intelliputer/video-composites/atari/doc/pcb-snapshot.png

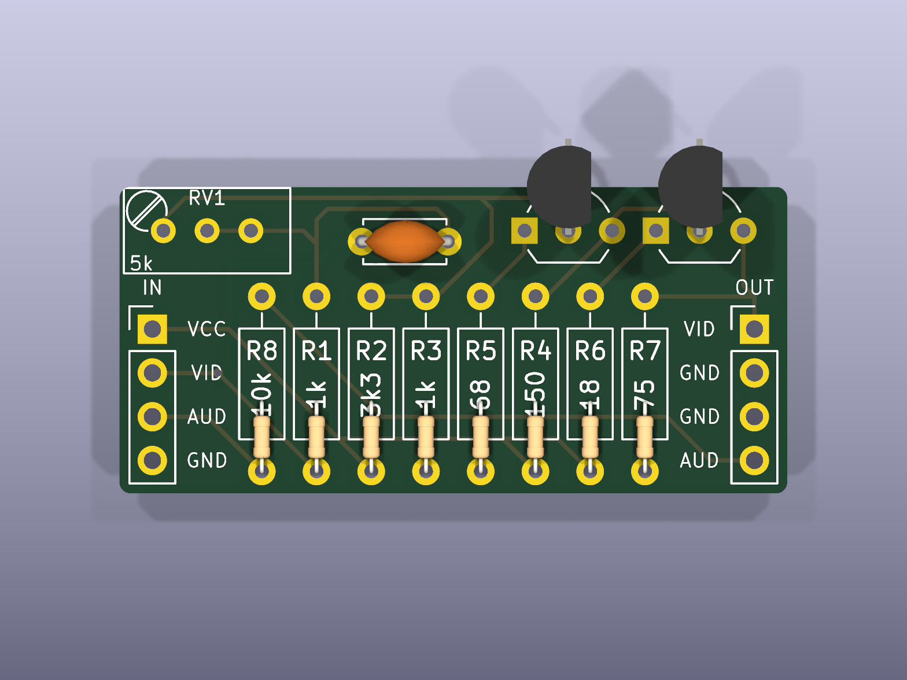
atari/doc/pcb-snapshot.png
