intelliputer/video-composites/atari/gallery/2019-01-28 23.04.03.jpg

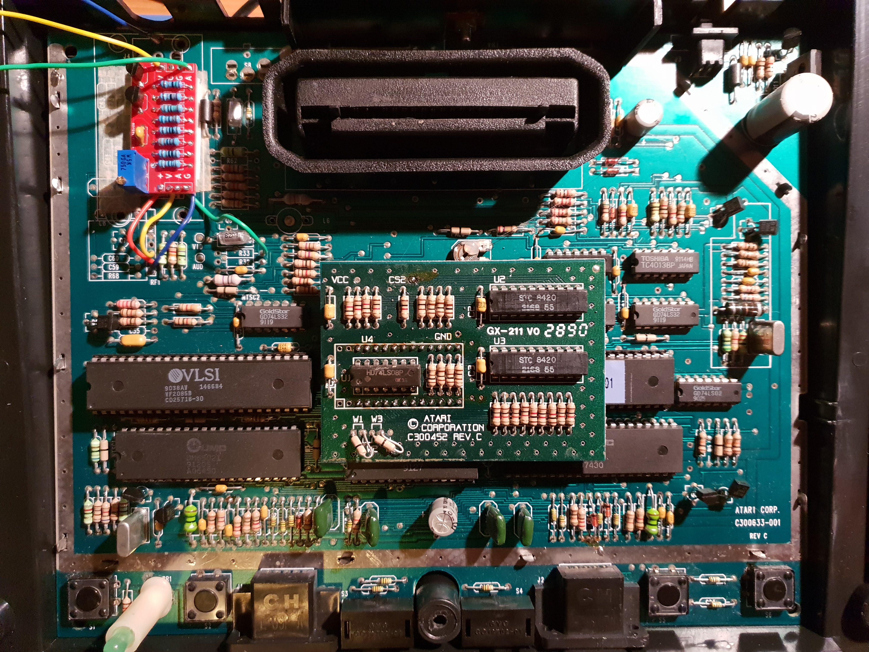
atari/gallery/2019-01-28 23.04.03.jpg
