intelliputer/video-composites/intellivision/doc/pcb-snapshot.png

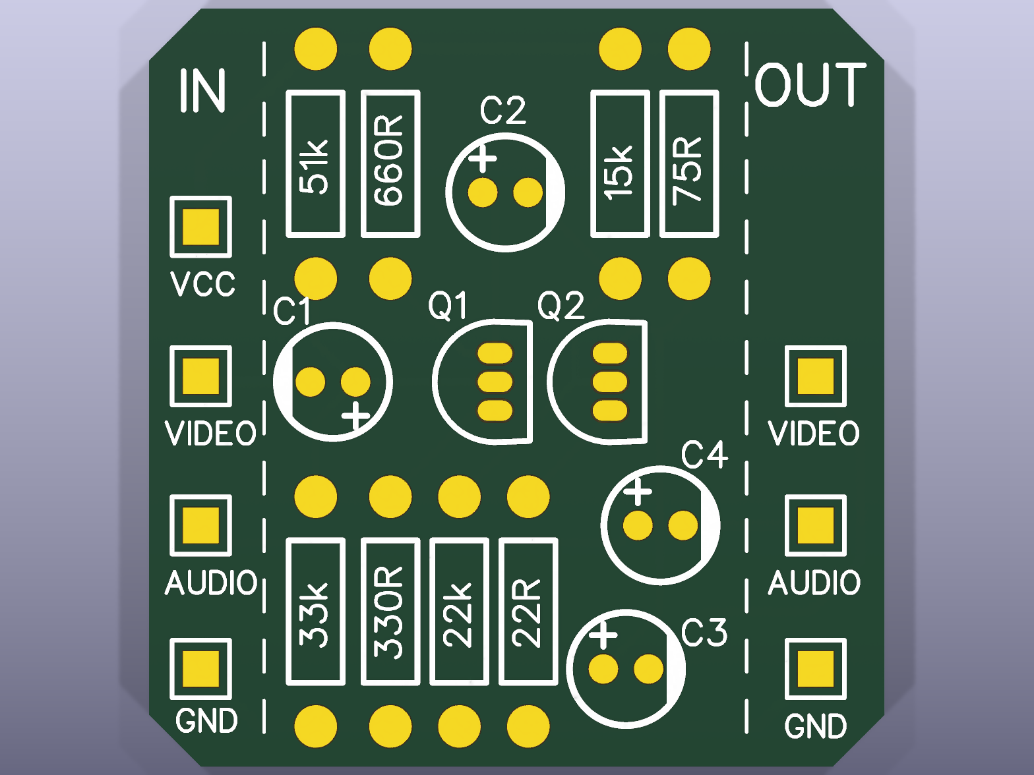
intellivision/doc/pcb-snapshot.png
