intelliputer/video-composites/intellivision/doc/schematic.jpg

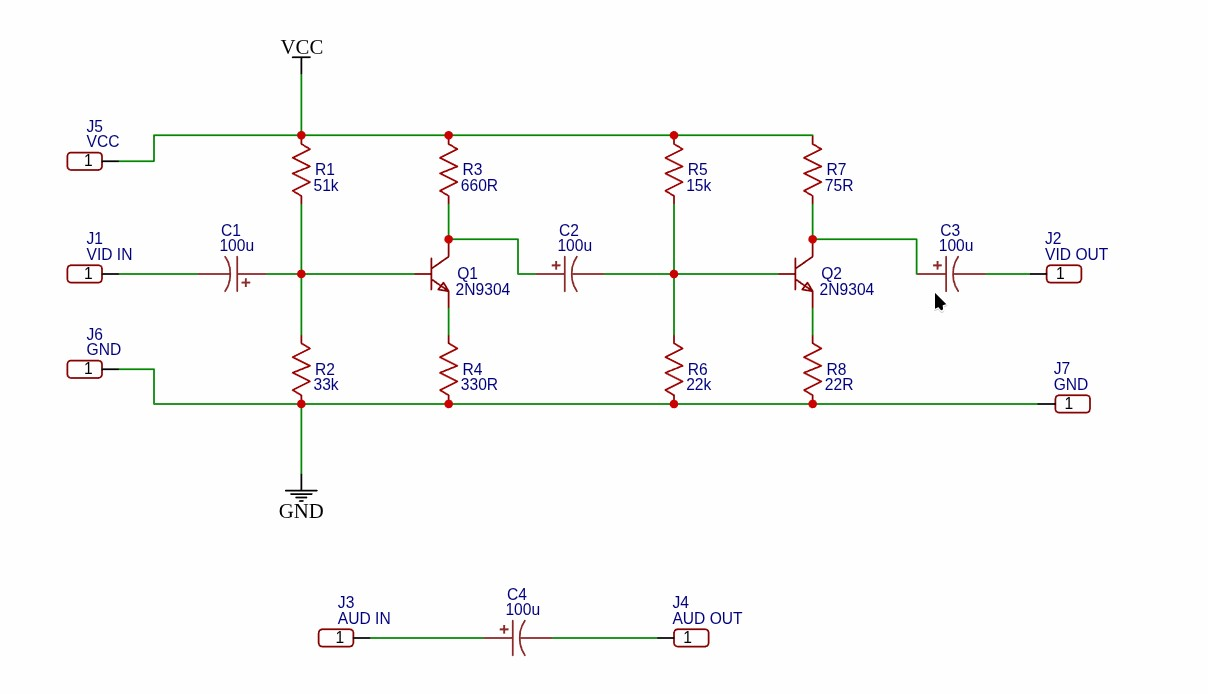
intellivision/doc/schematic.jpg
