intelliputer/video-composites/live/2026-10-26-intellivision-ii-raw-video-narrow-sync.jpg

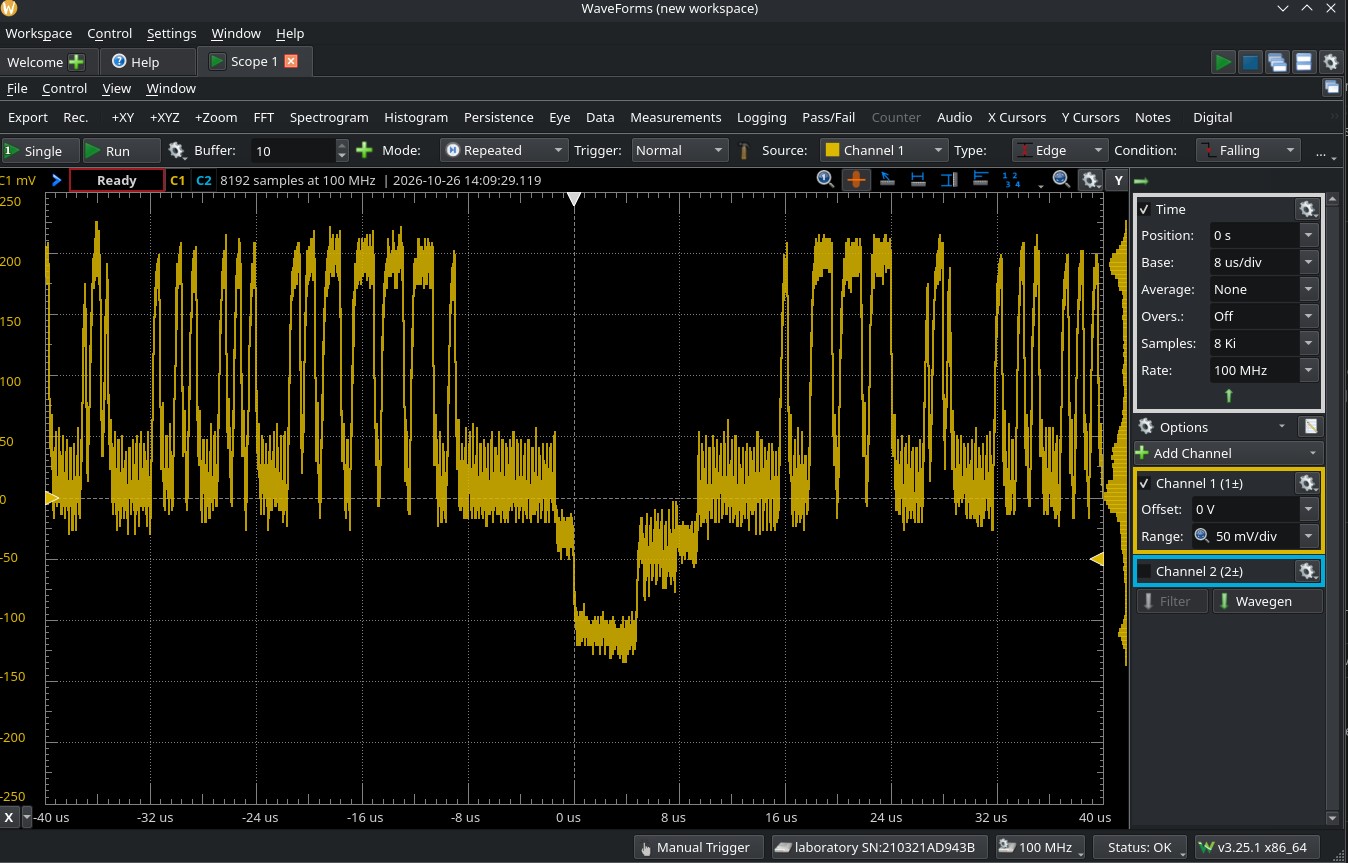
live/2026-10-26-intellivision-ii-raw-video-narrow-sync.jpg
