intelliputer/video-composites/live/2026-10-26-intellivision-ii-raw-video-wide.jpg

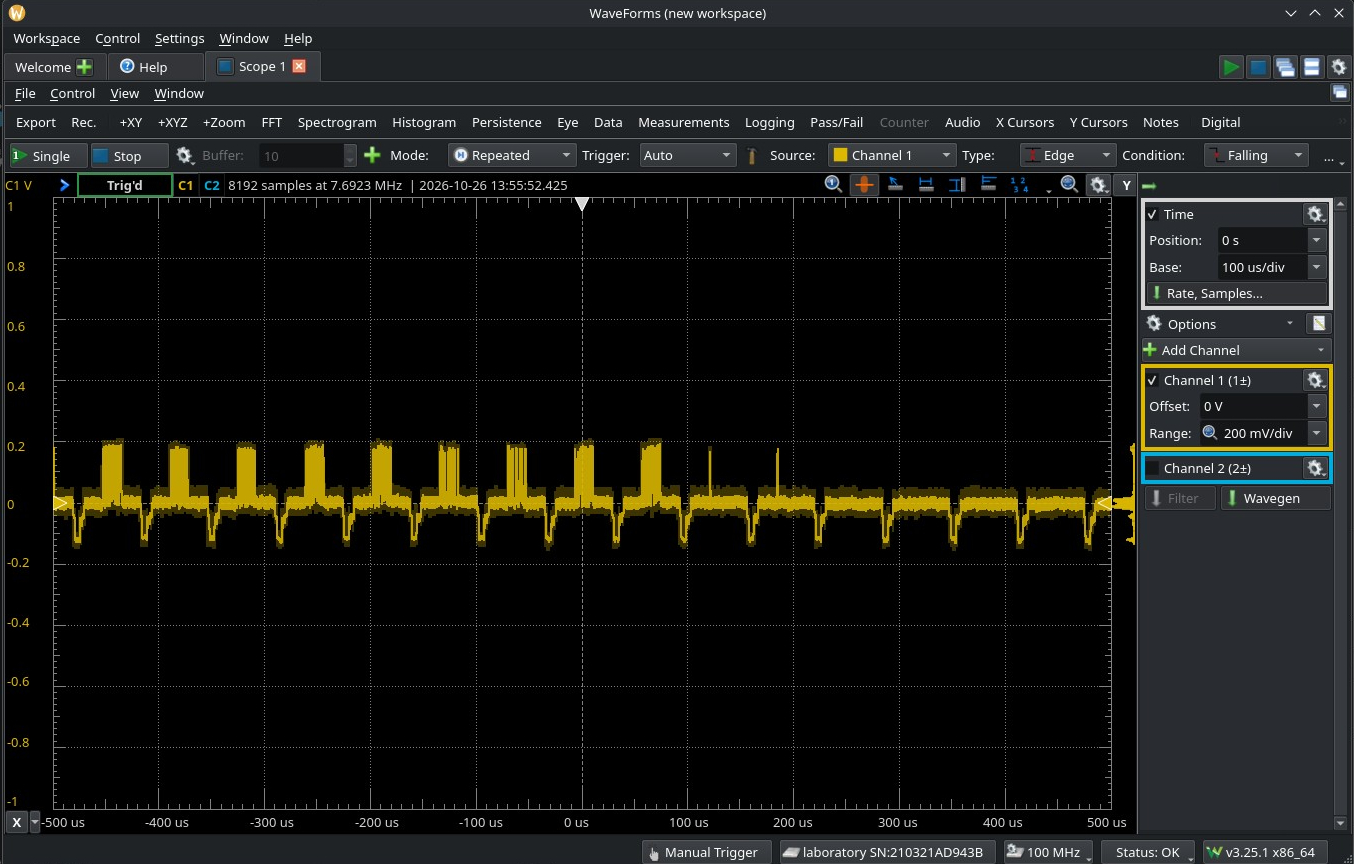
live/2026-10-26-intellivision-ii-raw-video-wide.jpg
