intelliputer/video-composites/intellivision/project/kicad/intv-video-composite.kicad_pcb

## KiCad design intellivision/project/kicad/intv-video-composite.kicad_pcb (2026-10-26)

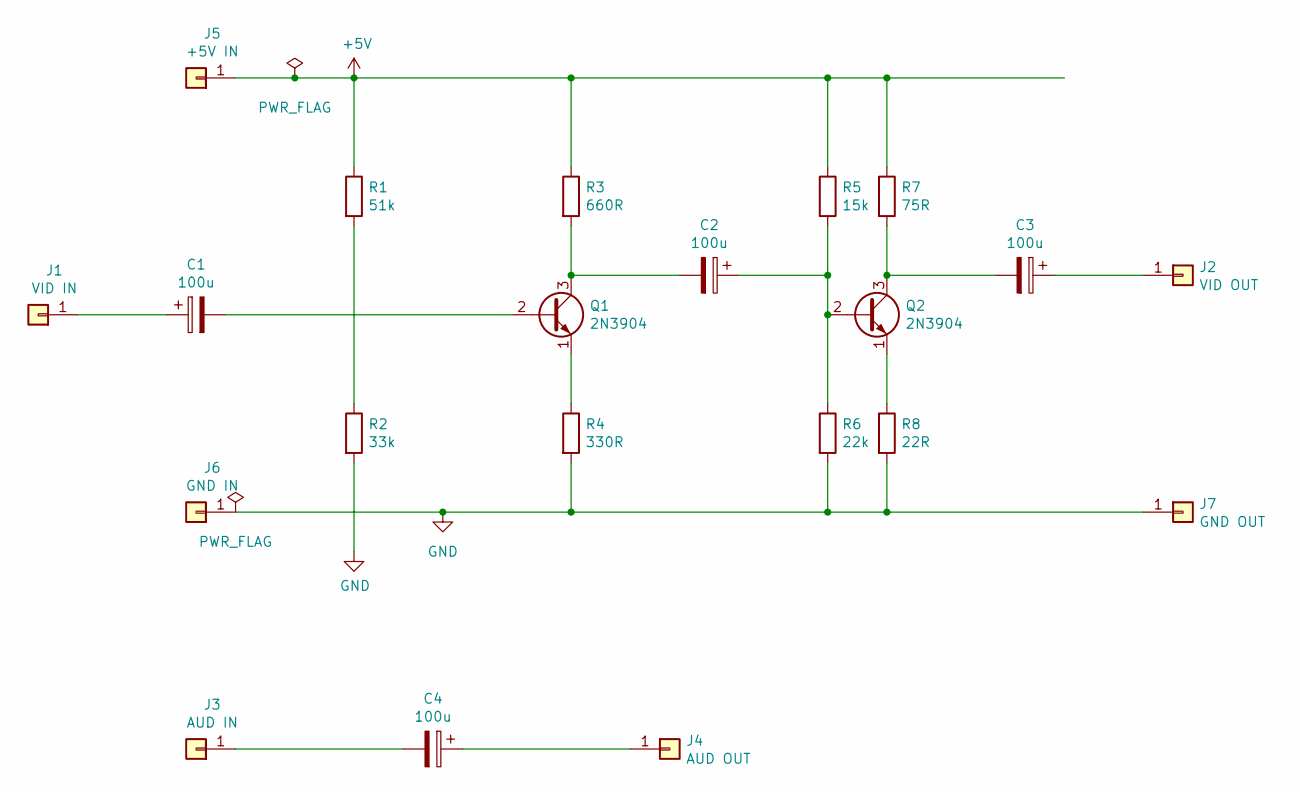
[picture p28: schematic intv-video-composite.kicad_sch, Intellivision Composite Video Amplifier]

Parts:
C1, C2, C3, C4: 100u; CP_Radial_D6.3mm_P2.50mm
J1: VID IN; WirePad_1x01_D3.5mm_Drill1.3mm
J2: VID OUT; WirePad_1x01_D3.5mm_Drill1.3mm
J3: AUD IN; WirePad_1x01_D3.5mm_Drill1.3mm
J4: AUD OUT; WirePad_1x01_D3.5mm_Drill1.3mm
J5: +5V IN; WirePad_1x01_D3.5mm_Drill1.3mm
J6: GND IN; WirePad_1x01_D3.5mm_Drill1.3mm
J7: GND OUT; WirePad_1x01_D3.5mm_Drill1.3mm
Q1, Q2: 2N3904; TO-92_Inline_OAR175
R1: 51k; R_Axial_DIN0207_L6.3mm_D2.5mm_P10.16mm_Horizontal
R2: 33k; R_Axial_DIN0207_L6.3mm_D2.5mm_P10.16mm_Horizontal
R3: 660R; R_Axial_DIN0207_L6.3mm_D2.5mm_P10.16mm_Horizontal
R4: 330R; R_Axial_DIN0207_L6.3mm_D2.5mm_P10.16mm_Horizontal
R5: 15k; R_Axial_DIN0207_L6.3mm_D2.5mm_P10.16mm_Horizontal
R6: 22k; R_Axial_DIN0207_L6.3mm_D2.5mm_P10.16mm_Horizontal
R7: 75R; R_Axial_DIN0207_L6.3mm_D2.5mm_P10.16mm_Horizontal
R8: 22R; R_Axial_DIN0207_L6.3mm_D2.5mm_P10.16mm_Horizontal

Connections:
+5V: J5.1 (Pin_1_1), R1.1, R3.1, R5.1, R7.1
GND: J6.1 (Pin_1_1), J7.1 (Pin_1_1), R2.2, R4.2, R6.2, R8.2
unnamed: C1.1, J1.1 (Pin_1_1)
unnamed: C3.1, J2.1 (Pin_1_1)
unnamed: C4.2, J3.1 (Pin_1_1)
unnamed: C4.1, J4.1 (Pin_1_1)
unnamed: C1.2, Q1.2 (B)
unnamed: C2.2, Q1.3 (C), R3.2
unnamed: Q1.1 (E), R4.1
unnamed: C2.1, Q2.2 (B), R5.2, R6.1
unnamed: C3.2, Q2.3 (C), R7.2
unnamed: Q2.1 (E), R8.1
unnamed: R1.2, R2.1

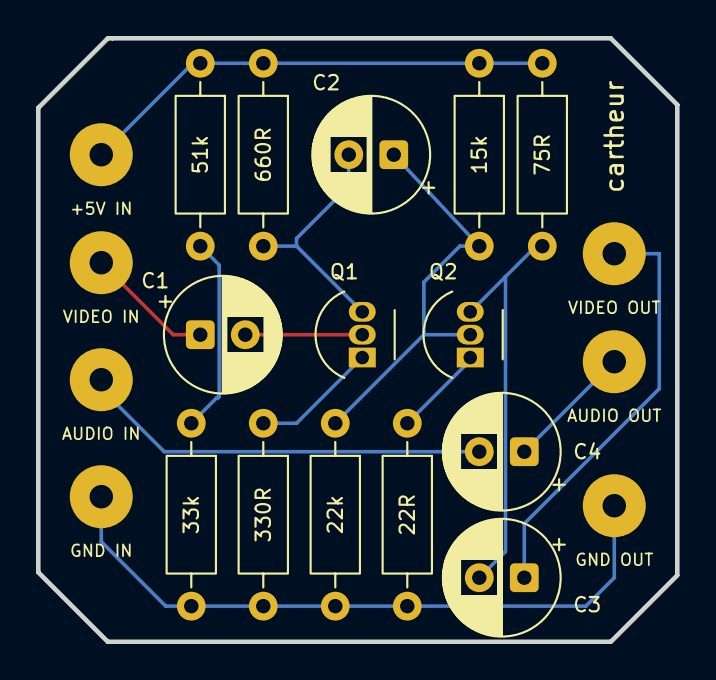
[picture p29: board intv-video-composite.kicad_pcb from above]

Board: 2 copper layers, 35.5 x 33.5 mm, 21 parts (1 on the bottom side), 13 nets.
