intelliputer/video-composites/atari/project/kicad/atari-composite.kicad_pcb

## KiCad design atari/project/kicad/atari-composite.kicad_pcb (2026-10-17)

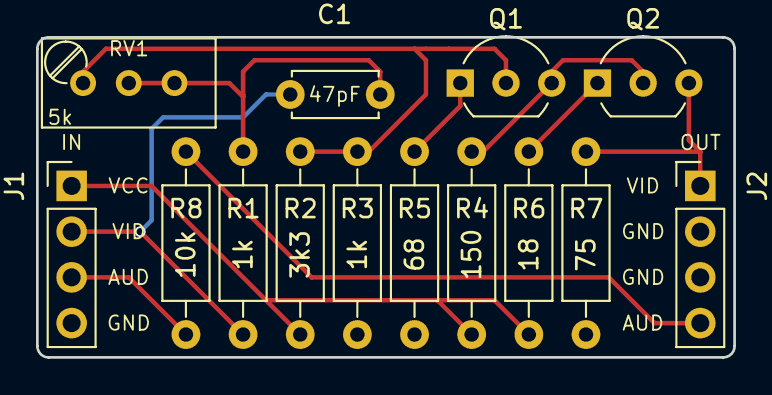
[picture p30: board atari-composite.kicad_pcb from above]

Board: 2 copper layers, 38.7 x 17.8 mm, 14 parts (0 on the bottom side), 11 nets.

Parts:
C1: 47pF; C_Disc_D4.7mm_W2.5mm_P5.00mm
J1: Video; Pin_Header_Straight_1x04_Pitch2.54mm
J2: Output; Pin_Header_Straight_1x04_Pitch2.54mm
Q1: 2N3904; TO-92_Inline_Wide
Q2: 2N3906; TO-92_Inline_Wide
R1, R3: 1k; R_Axial_DIN0207_L6.3mm_D2.5mm_P10.16mm_Horizontal
R2: 3k3; R_Axial_DIN0207_L6.3mm_D2.5mm_P10.16mm_Horizontal
R4: 150; R_Axial_DIN0207_L6.3mm_D2.5mm_P10.16mm_Horizontal
R5: 68; R_Axial_DIN0207_L6.3mm_D2.5mm_P10.16mm_Horizontal
R6: 18; R_Axial_DIN0207_L6.3mm_D2.5mm_P10.16mm_Horizontal
R7: 75; R_Axial_DIN0207_L6.3mm_D2.5mm_P10.16mm_Horizontal
R8: 10k; R_Axial_DIN0207_L6.3mm_D2.5mm_P10.16mm_Horizontal
RV1: 5k; Potentiometer_Trimmer_Bourns_3296W

Connections:
/AUD_IN: J1.3, R8.1
/AUD_OUT: J2.4, R8.2
/VID_IN: C1.2, J1.2, R1.1
/VID_OUT: J2.1, Q2.3, R7.2
GND: J1.4, J2.2, J2.3, R3.1, R5.1, R7.1
unnamed: C1.1, R1.2, RV1.2, RV1.3
unnamed: Q1.1, R5.2
unnamed: Q1.2, R2.2, R3.2, RV1.1
unnamed: Q1.3, Q2.2, R4.2
unnamed: Q2.1, R6.2
VCC: J1.1, R2.1, R4.1, R6.1
