intelliputer/video-composites/universal/project/kicad/universal-composite.kicad_pcb

## KiCad design universal/project/kicad/universal-composite.kicad_pcb (2026-10-17)

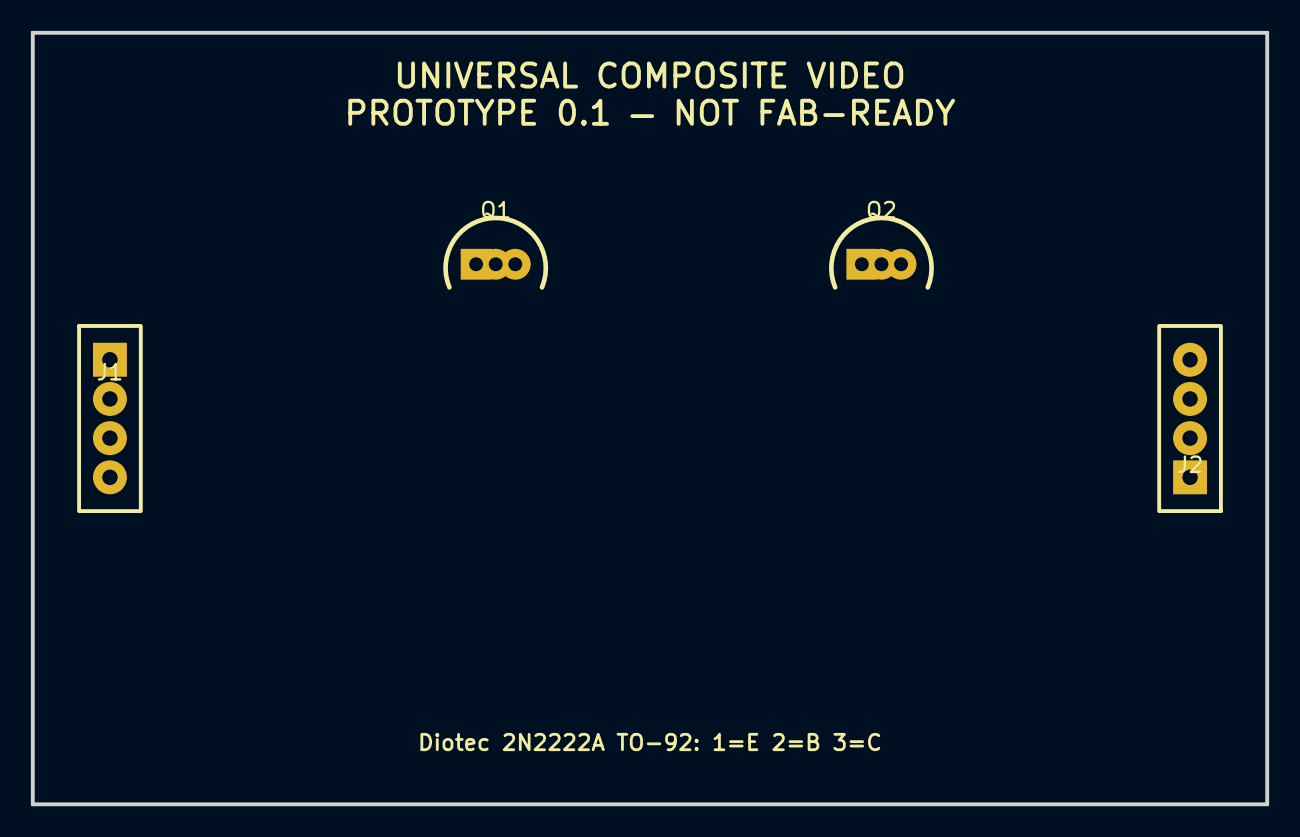
[picture p31: board universal-composite.kicad_pcb from above]

Board: 2 copper layers, 80.0 x 50.0 mm, 4 parts (0 on the bottom side), 2 nets, no tracks yet.

Parts:
J1: CONSOLE; Header_1x04
J2: A/V OUT; Header_1x04
Q1, Q2: 2N2222A EBC; TO-92_EBC

Connections:
+5V: J1.1, J2.1
GND: J1.2, J2.2
