intelliputer/video-composites/(commit log)

2026-10-13 Initial version
    [intellivision-mod.kicad_pcb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]
2026-10-13 Cleaner version
    [intellivision-composite.kicad_pcb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]
2026-10-17 Add kicad projects
    [intellivision-composite.kicad_pcb, intellivision-composite.kicad_sch, intellivision-mod.kicad_pcb]
2026-10-17 Add Atari 2600 composite video amplifier
    [atari-composite.kicad_pcb, atari-composite.kicad_sch]
2026-10-17 Document video mod circuits and prototype universal design
    [atari-composite.kicad_pcb, atari-composite.kicad_sch, intellivision-composite.kicad_pcb, intellivision-composite.sch, intellivision-mod.kicad_pcb, universal-composite.kicad_pcb]
2026-10-20 Draft universal concept
    [universal-composite.kicad_sch, universal-composite.sch]
2026-10-20 Current board state
    [intellivision-composite-rebuilt.kicad_pcb, intellivision-composite-rebuilt.kicad_sch]
2026-10-20 Add routing
    [intellivision-composite-rebuilt.kicad_pcb, intellivision-composite-rebuilt.kicad_sch]
2026-10-20 Finalize build model
    [intellivision-composite-rebuilt.kicad_pcb]
2026-10-20 Advance board
    [intellivision-composite-rebuilt-B_Cu.gbr, intellivision-composite-rebuilt-B_Mask.gbr, intellivision-composite-rebuilt-Edge_Cuts.gbr, intellivision-composite-rebuilt-F_Cu.gbr, intellivision-composite-rebuilt-F_Mask.gbr, intellivision-composite-rebuilt-F_Silkscreen.gbr, intellivision-composite-rebuilt-job.gbrjob, intellivision-composite-rebuilt.drl]
2026-10-21 Add values for passives
    [intellivision-composite-rebuilt.kicad_pcb]
2026-10-21 Rename Intellivision composite production set
    [intv-video-composite-B_Cu.gbr, intv-video-composite-B_Mask.gbr, intv-video-composite-Edge_Cuts.gbr, intv-video-composite-F_Cu.gbr, intv-video-composite-F_Mask.gbr, intv-video-composite-F_Silkscreen.gbr, intv-video-composite-job.gbrjob, intv-video-composite.drl]
2026-10-26 docs: record Intellivision II raw video captures
    [2026-10-26-intellivision-ii-raw-video-narrow-sync.csv, 2026-10-26-intellivision-ii-raw-video-narrow.csv, 2026-10-26-intellivision-ii-raw-video-wide.csv]
2026-10-26 chore: advance Intellivision production validation
    [intv-video-composite.kicad_sch]
2026-10-26 docs: specify verified Intellivision capacitors
2026-10-26 Update to rev.1
    [intv-video-composite-B_Cu.gbr, intv-video-composite-B_Mask.gbr, intv-video-composite-B_Paste.gbr, intv-video-composite-B_Silkscreen.gbr, intv-video-composite-Edge_Cuts.gbr, intv-video-composite-F_Cu.gbr, intv-video-composite-F_Mask.gbr, intv-video-composite-F_Paste.gbr]
2026-10-26 Update Intellivision Rev.1 silkscreen release
    [intv-video-composite-B_Cu.gbr, intv-video-composite-B_Mask.gbr, intv-video-composite-B_Paste.gbr, intv-video-composite-B_Silkscreen.gbr, intv-video-composite-Edge_Cuts.gbr, intv-video-composite-F_Cu.gbr, intv-video-composite-F_Mask.gbr, intv-video-composite-F_Paste.gbr]
2026-10-26 De way i like it
    [intv-video-composite-B_Cu.gbr, intv-video-composite-B_Mask.gbr, intv-video-composite-B_Paste.gbr, intv-video-composite-B_Silkscreen.gbr, intv-video-composite-Edge_Cuts.gbr, intv-video-composite-F_Cu.gbr, intv-video-composite-F_Mask.gbr, intv-video-composite-F_Paste.gbr]
